danheidel/Passthrough-Meter/Passthrough Meter.brd

## EAGLE design Passthrough Meter.brd (2012-05-22)

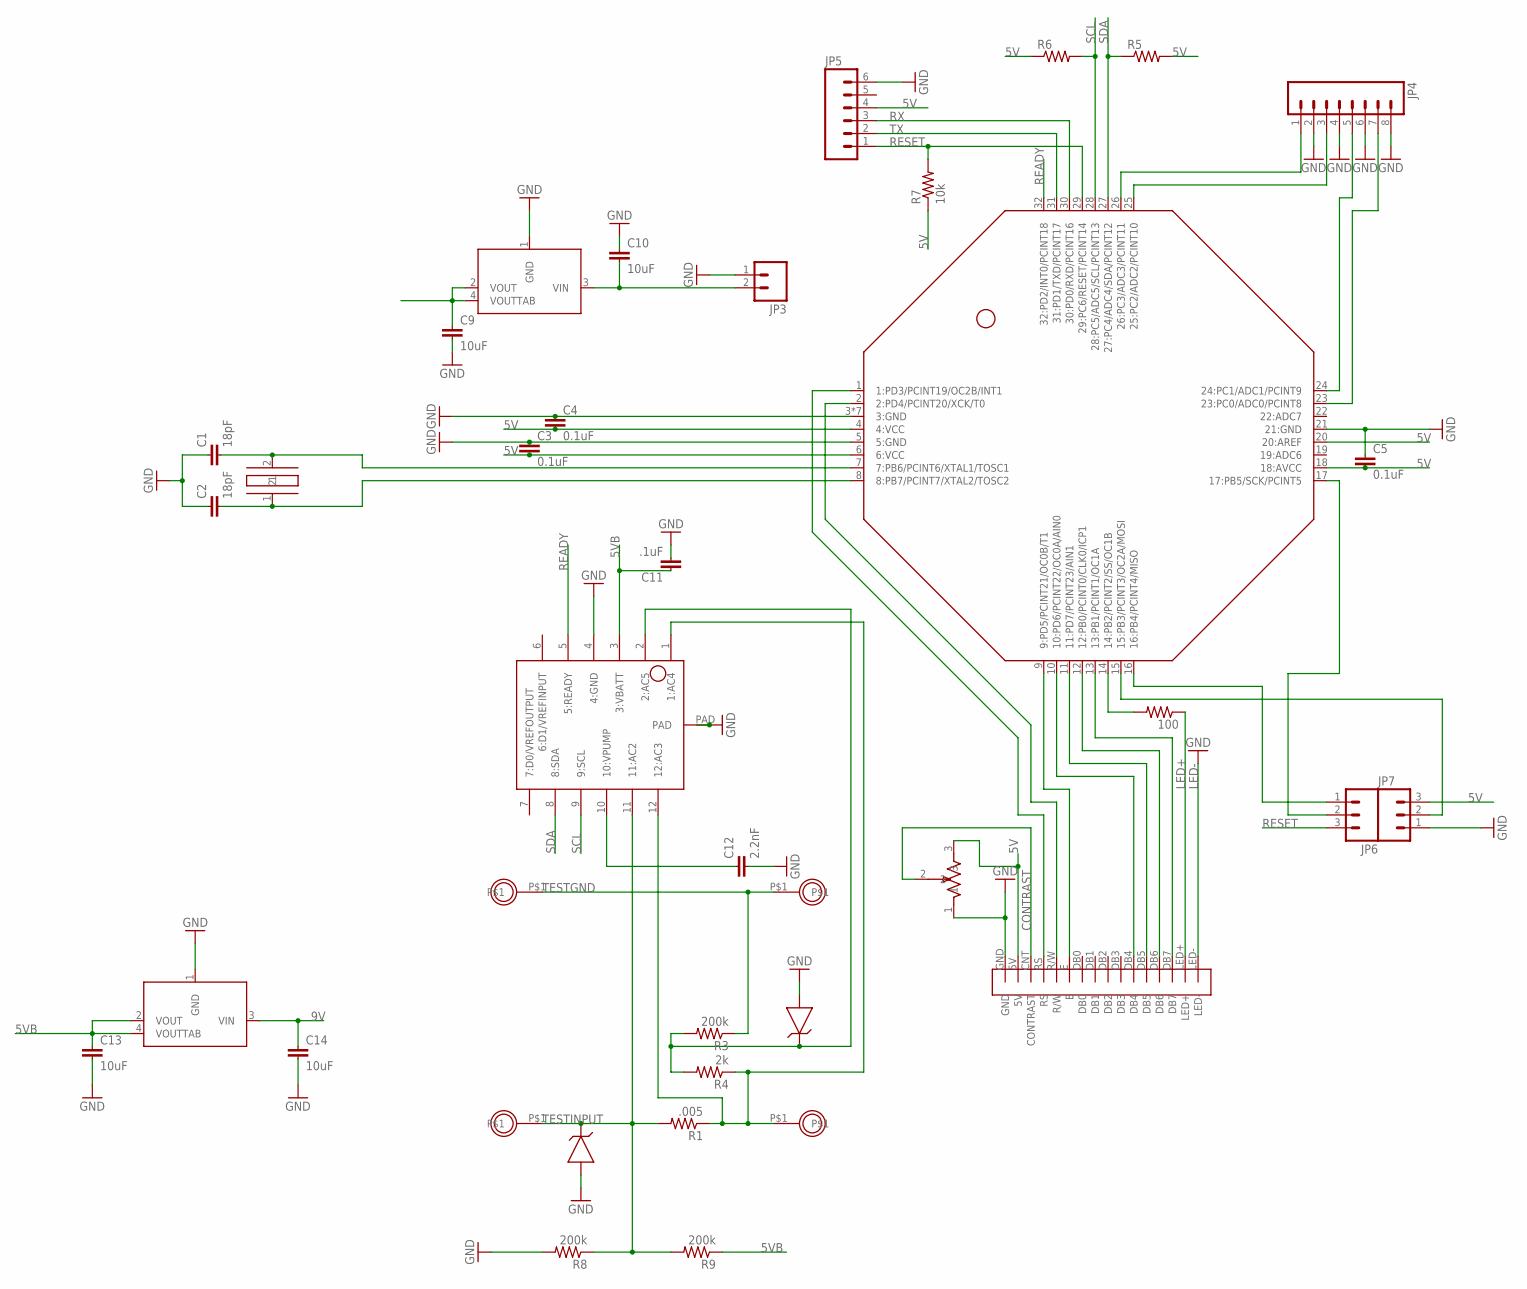
[picture p1: schematic Passthrough Meter.sch]

Parts:
100: RESISTOR; 0805
C1, C2: 18pF; 0603-CAP
C3, C4, C5: 0.1uF; 0805
C9, C10, C13, C14: 10uF; 1206
C11: .1uF; 0805
C12: 2.2nF; 0805
JP3: M02LOCK; 1X02_LOCK
JP4: M08LOCK; 1X08_LOCK
JP5: M06LOCK; 1X06_LOCK
JP6, JP7: M03LOCK; 1X03_LOCK
R1: .005; OAR5
R3, R8, R9: 200k; PRECISION-R1
R4: 2k; 0805
R5, R6: RESISTOR; 0805
R7: 10k; 0805
U$1: HC49US
U$3: ATMEGA328SMD-QFN; QFN-32
U$4: SX8723; MPLD-W-12-4X4
U$5, U$15: ZENER_DIODE-SOD-323; SOD-323
U$6: TRIMPOTTC33X-2; TC33X-2
U$7, U$8, U$9, U$10: THROUGH_HOLE-3MM; THROUGH_HOLE_2.2MM
U$13, U$14: 5V-LDO-ZLDO1117; ZLDO1117
U$16: LCD

Connections:
5V: C3.2, C4.2, C5.2, C9.1, JP5.4, JP7.3, R5.2, R6.1, R7.1, U$3.4 (4:VCC), U$3.6 (6:VCC), U$3.18 (18:AVCC), U$3.20 (20:AREF), U$6.3, U$13.2 (VOUT), U$13.4 (VOUTTAB), U$16.5V
5VB: C11.1, C13.1, R9.1, U$4.3 (3:VBATT), U$14.2 (VOUT), U$14.4 (VOUTTAB)
9V: C10.2, C14.1, JP3.2, U$13.3 (VIN), U$14.3 (VIN)
A0: JP4.7, U$3.23 (23:PC0/ADC0/PCINT8)
A1: JP4.5, U$3.24 (24:PC1/ADC1/PCINT9)
A2: JP4.3, U$3.25 (25:PC2/ADC2/PCINT10)
A3: JP4.1, U$3.26 (26:PC3/ADC3/PCINT11)
CONTRAST: U$6.2, U$16.CNT (CONTRAST)
DB7: JP7.2, U$3.15 (15:PB3/PCINT3/OC2A/MOSI)
GND: C1.1, C2.1, C3.1, C4.1, C5.1, C9.2, C10.1, C11.2, C12.2, C13.2, C14.2, JP3.1, JP4.2, JP4.4, JP4.6, JP4.8, JP5.6, JP7.1, R8.2, U$3.3 (3:GND), U$3.5 (5:GND), U$3.21 (21:GND), U$3.P1 (3:GND), U$3.P2 (3:GND), U$3.P3 (3:GND), U$3.P4 (3:GND), U$3.P5 (3:GND), U$3.PAD (3:GND), U$4.4 (4:GND), U$4.PAD, U$5.2 (A), U$6.1, U$13.1 (GND), U$14.1 (GND), U$15.2 (A), U$16.GND
LED+: 100.1, U$16.LED+
LED-: U$16.LED-
MISO: JP6.1, U$3.16 (16:PB4/PCINT4/MISO)
unnamed: C2.2, U$1.1, U$3.8 (8:PB7/PCINT7/XTAL2/TOSC2)
unnamed: C1.2, U$1.2, U$3.7 (7:PB6/PCINT6/XTAL1/TOSC1)
unnamed: 100.2, U$3.14 (14:PB2/PCINT2/SS/OC1B)
unnamed: U$3.13 (13:PB1/PCINT1/OC1A), U$16.DB7
unnamed: U$3.12 (12:PB0/PCINT0/CLK0/ICP1), U$16.DB6
unnamed: U$3.11 (11:PD7/PCINT23/AIN1), U$16.DB5
unnamed: U$3.10 (10:PD6/PCINT22/OC0A/AIN0), U$16.DB4
unnamed: U$3.9 (9:PD5/PCINT21/OC0B/T1), U$16.E
unnamed: U$3.2 (2:PD4/PCINT20/XCK/T0), U$16.R/W
unnamed: U$3.1 (1:PD3/PCINT19/OC2B/INT1), U$16.RS
unnamed: C12.1, U$4.10 (10:VPUMP)
unnamed: R3.2, R4.2, U$4.2 (2:AC5), U$5.1 (C)
READY: U$3.32 (32:PD2/INT0/PCINT18), U$4.5 (5:READY)
RESET: JP5.1, JP6.3, R7.2, U$3.29 (29:PC6/RESET/PCINT14)
RX: JP5.3, U$3.30 (30:PD0/RXD/PCINT16)
SCK: JP6.2, U$3.17 (17:PB5/SCK/PCINT5)
SCL: R6.2, U$3.28 (28:PC5/ADC5/SCL/PCINT13), U$4.9 (9:SCL)
SDA: R5.1, U$3.27 (27:PC4/ADC4/SDA/PCINT12), U$4.8 (8:SDA)
TESTGND: R3.1, U$7.P$1, U$8.P$1
TESTINPUT: R1.2, R8.1, R9.2, U$4.11 (11:AC2), U$9.P$1, U$15.1 (C)
TESTOUTPUT: R1.1, R4.1, U$4.1 (1:AC4), U$4.12 (12:AC3), U$10.P$1
TX: JP5.2, U$3.31 (31:PD1/TXD/PCINT17)

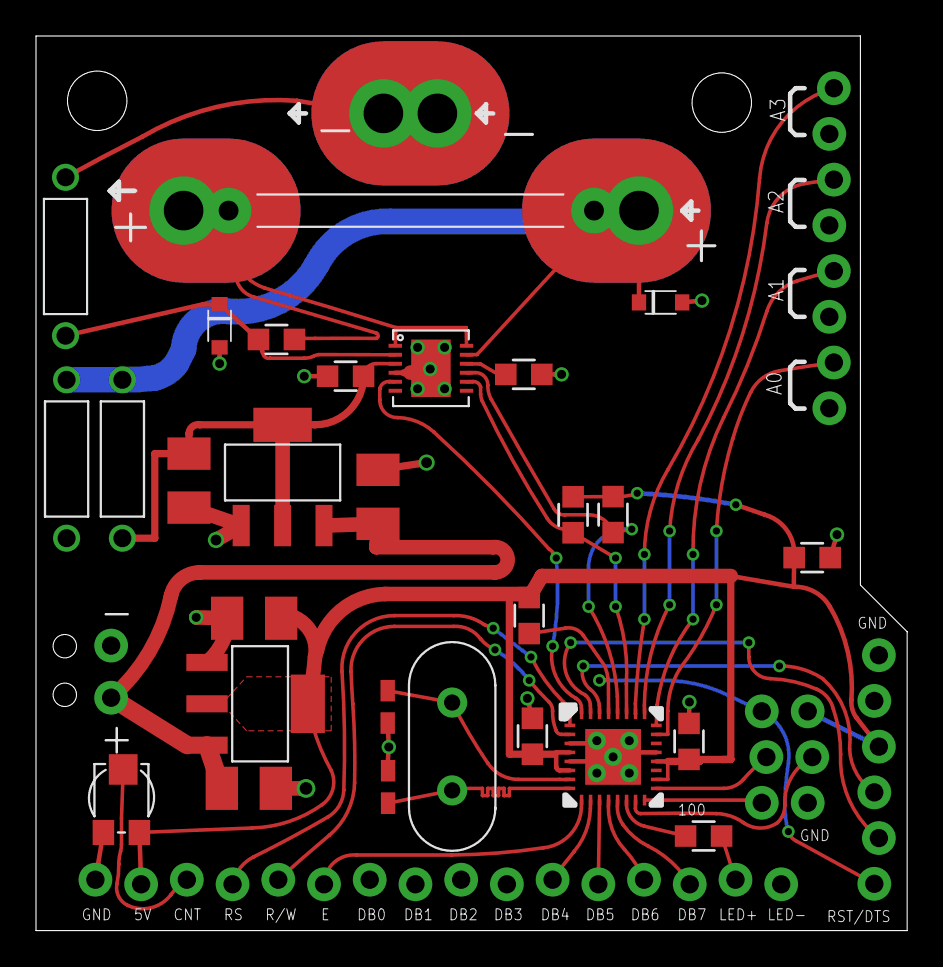
[picture p2: board Passthrough Meter.brd from above]

Board: 2 copper layers, 48.4 x 49.7 mm, 40 parts (0 on the bottom side), 34 nets.

Other parts of the board:
U$11, U$12: STAND-OFF
