danheidel/Passthrough-Meter/(commit log)

2011-06-01 1st commit
    [Passthrough Meter.sch]
2011-11-22 Lots of changes, this is version sent off for first board run.
    [Passthrough Meter.GBL, Passthrough Meter.GBO, Passthrough Meter.GBP, Passthrough Meter.GBS, Passthrough Meter.GTL, Passthrough Meter.GTO, Passthrough Meter.GTP, Passthrough Meter.GTS]
2011-12-01 Resized power holes for 12 AWG solid wire, moved them closer to merge soldermask offset so soler can bridge between wires & current resistor to lower extraneous resistance. Changed PS to the correct 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
    [Passthrough Meter.GBL, Passthrough Meter.GBO, Passthrough Meter.GBP, Passthrough Meter.GBS, Passthrough Meter.GTL, Passthrough Meter.GTO, Passthrough Meter.GTP, Passthrough Meter.GTS]
2011-12-16 Major changes, now changed to new version of ADC, large clean up of trace placement, changed resistors to larger voltage standoff throughholes, overvoltage protection diodes, whole board now floats w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
    [Passthrough Meter.GBL, Passthrough Meter.GBO, Passthrough Meter.GBP, Passthrough Meter.GBS, Passthrough Meter.GTL, Passthrough Meter.GTO, Passthrough Meter.GTP, Passthrough Meter.GTS]
2011-12-24 File cleanup - deleted Eagle backup files - other minor edits
    [Passthrough Meter.brd, Passthrough Meter.sch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]
2012-04-26 .eps tweaks
    [Passthrough Meter.brd]
2012-04-26 fixup! .eps tweaks
    [Passthrough Meter.brd, Passthrough Meter.sch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]
2012-05-22 Major revision
    Removed voltage reference, redid much of the board for better noise and lower BOM.
    [Passthrough Meter.brd, Passthrough Meter.sch]
